sunglen/omni3/doc/JGB37-3530B-24V-333RPM/TB2.rUPbpXXXXXpXpXXXXXXXXXX-665327151.png

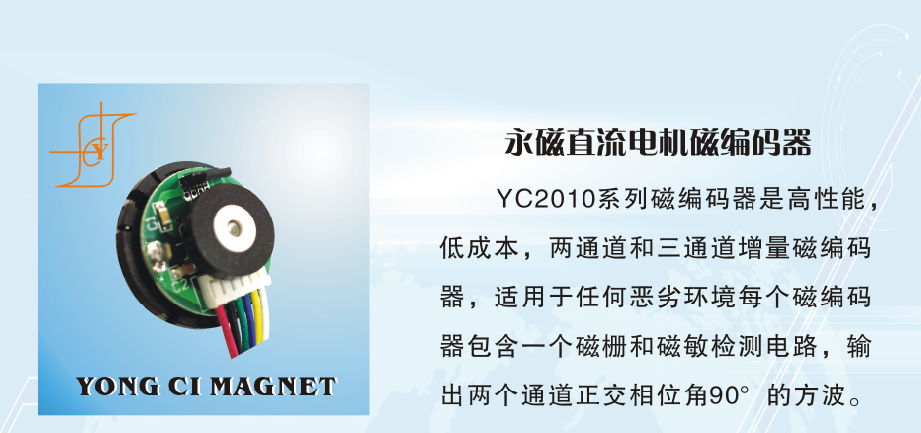
doc/JGB37-3530B-24V-333RPM/TB2.rUPbpXXXXXpXpXXXXXXXXXX-665327151.png
