sunglen/omni3/README.md

omni3
====

AGV with three omni wheels, prototype

- gcc: firmware, gcc

- omni3v0-dist: firmware, Keil uVision

- doc: related documents

- pcb: Eagle Schematics, PCB and Gerber files
