sunglen/omni3/doc/JGB37-3530B-24V-333RPM/TB2dm7LbpXXXXanXpXXXXXXXXXX-665327151 (1).png

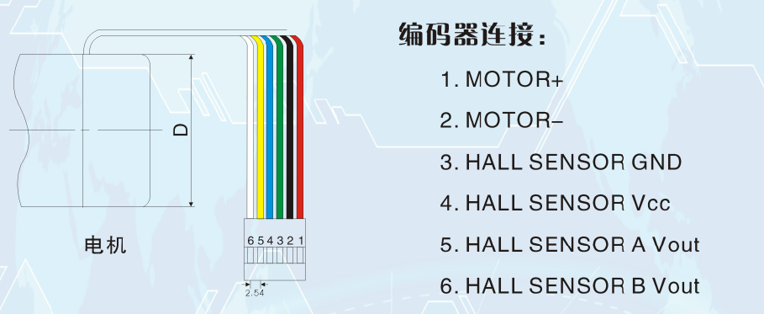
doc/JGB37-3530B-24V-333RPM/TB2dm7LbpXXXXanXpXXXXXXXXXX-665327151 (1).png
