sunglen/omni3/doc/JGB37-3530B-24V-333RPM/TB2ShL6bVXXXXXFXXXXXXXXXXXX-665327151.png

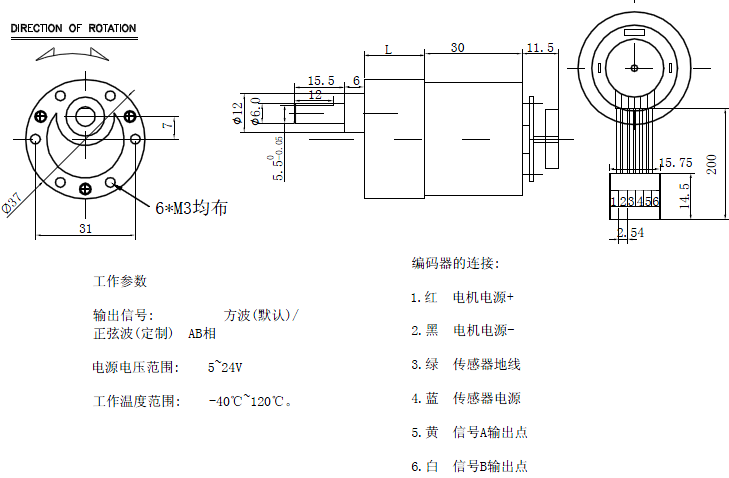
doc/JGB37-3530B-24V-333RPM/TB2ShL6bVXXXXXFXXXXXXXXXXXX-665327151.png
