sunglen/omni3/doc/JGB37-3530B-24V-333RPM/黄A绿B反转.png

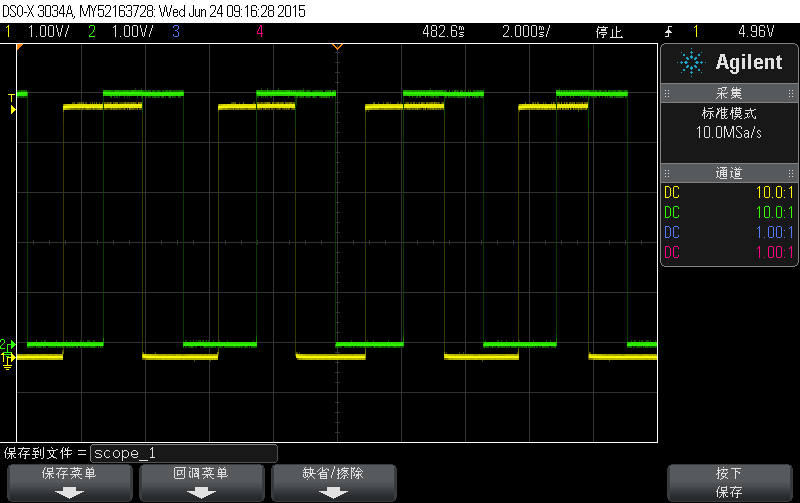
doc/JGB37-3530B-24V-333RPM/黄A绿B反转.png
