sunglen/omni3/pcb/mcs-1-32.brd

## EAGLE design pcb/mcs-1-32.brd (2018-05-24)

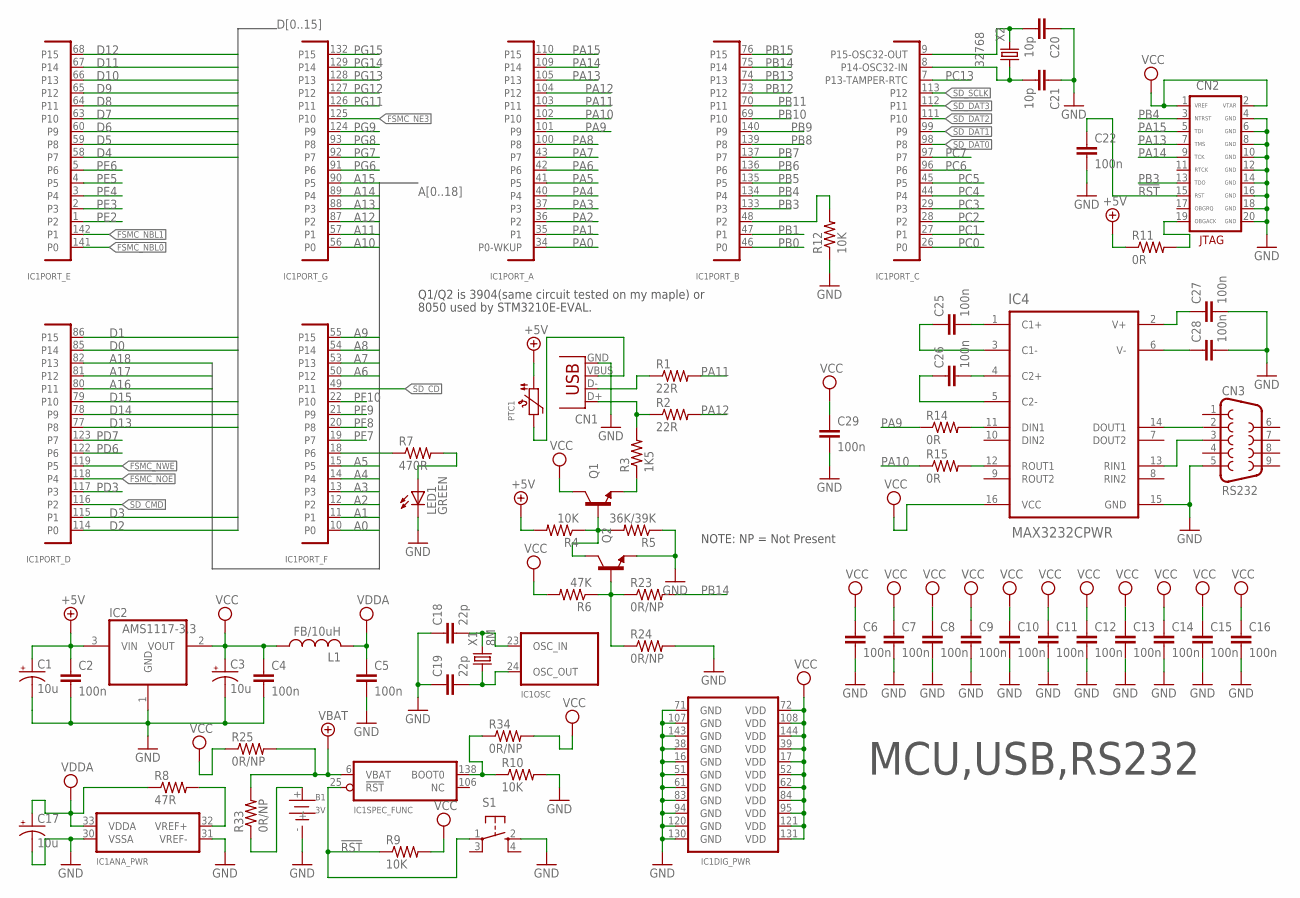
[picture p12: schematic mcs-1-32.sch, sheet 1]

Parts:
B1: 3V; 1220-SMD
C1, C3, C17: 10u; EIA3216
C2, C4, C5, C6, C7, C8, C9, C10, C11, C12, C13, C14, C15, C16, C22, C25, C26, C27, C28, C29: 100n; 0603-CAP
C18, C19: 22p; 0603-CAP
C20, C21: 10p; 0603-CAP
CN1: USBSMD; USB-MINIB
CN2: JTAG-ARM-HDR100; JTAG-ARM
CN3: RS232; DB9
IC1: STM32F103ZE; SQFP-S-20X20-144
IC2: AMS1117-3.3; BURR-BROWN_SOT223
IC4: MAX3232CPWR; SOP65P640X120-16N
L1: FB/10uH; L2012C
LED1: GREEN; CHIPLED_0805
PTC1: PTCPTC0805; PTC0805
Q1, Q2: TRANSISTOR_NPNSOT23-3; SOT23-3
R1, R2: 22R; 0603-RES
R3: 1K5; 0603-RES
R4, R9, R10, R12: 10K; 0603-RES
R5: 36K/39K; 0603-RES
R6: 47K; 0603-RES
R7: 470R; 0603-RES
R8: 47R; 0603-RES
R11, R14, R15: 0R; 0603-RES
R23, R24, R25, R33, R34: 0R/NP; 0603-RES
S1: SWITCH-TACT_SFKHHM
X1: 8M; HC49US
X2: 32768; CRYSTAL-32KHZ-3215

Connections:
!RST: C22.1, CN2.15 (RST), IC1.25 (!RST), R9.1, S1.1
+5V: C1.A (+), C2.1, IC2.3 (VIN), PTC1.1, R4.2, R11.1; also elsewhere on the board
A0: IC1.10 (P0); also elsewhere on the board
A1: IC1.11 (P1); also elsewhere on the board
A2: IC1.12 (P2); also elsewhere on the board
A3: IC1.13 (P3); also elsewhere on the board
A4: IC1.14 (P4); also elsewhere on the board
A5: IC1.15 (P5); also elsewhere on the board
A6: IC1.50 (P12); also elsewhere on the board
A7: IC1.53 (P13); also elsewhere on the board
A8: IC1.54 (P14); also elsewhere on the board
A9: IC1.55 (P15); also elsewhere on the board
A10: IC1.56 (P0); also elsewhere on the board
A11: IC1.57 (P1); also elsewhere on the board
A12: IC1.87 (P2); also elsewhere on the board
A13: IC1.88 (P3); also elsewhere on the board
A14: IC1.89 (P4); also elsewhere on the board
A15: IC1.90 (P5); also elsewhere on the board
A16: IC1.80 (P11); also elsewhere on the board
A17: IC1.81 (P12); also elsewhere on the board
A18: IC1.82 (P13); also elsewhere on the board
D0: IC1.85 (P14); also elsewhere on the board
D1: IC1.86 (P15); also elsewhere on the board
D2: IC1.114 (P0); also elsewhere on the board
D3: IC1.115 (P1); also elsewhere on the board
D4: IC1.58 (P7); also elsewhere on the board
D5: IC1.59 (P8); also elsewhere on the board
D6: IC1.60 (P9); also elsewhere on the board
D7: IC1.63 (P10); also elsewhere on the board
D8: IC1.64 (P11); also elsewhere on the board
D9: IC1.65 (P12); also elsewhere on the board
D10: IC1.66 (P13); also elsewhere on the board
D11: IC1.67 (P14); also elsewhere on the board
D12: IC1.68 (P15); also elsewhere on the board
D13: IC1.77 (P8); also elsewhere on the board
D14: IC1.78 (P9); also elsewhere on the board
D15: IC1.79 (P10); also elsewhere on the board
FSMC_NBL0: IC1.141 (P0); also elsewhere on the board
FSMC_NBL1: IC1.142 (P1); also elsewhere on the board
FSMC_NE3: IC1.125 (P10); also elsewhere on the board
FSMC_NOE: IC1.118 (P4); also elsewhere on the board
FSMC_NWE: IC1.119 (P5); also elsewhere on the board
GND: B1.-, C1.C (-), C2.2, C3.C (-), C4.2, C5.2, C6.2, C7.2, C8.2, C9.2, C10.2, C11.2, C12.2, C13.2, C14.2, C15.2, C16.2, C17.C (-), C18.1, C19.1, C20.1, C21.1, C22.2, C27.2, C28.2, C29.2, CN1.GND, CN2.4 (GND), CN2.6 (GND), CN2.8 (GND), CN2.10 (GND), CN2.12 (GND), CN2.14 (GND), CN2.16 (GND), CN2.18 (GND), CN2.20 (GND), CN3.5, IC1.16 (GND), IC1.30 (VSSA), IC1.31 (VREF-), IC1.38 (GND), IC1.51 (GND), IC1.61 (GND), IC1.71 (GND), IC1.83 (GND), IC1.94 (GND), IC1.107 (GND), IC1.120 (GND), IC1.130 (GND), IC1.143 (GND), IC2.1 (GND), IC4.15 (GND), LED1.C, Q2.2 (E), R5.1, R10.2, R12.1, R24.2, S1.2; also elsewhere on the board
unnamed: Q1.2 (E), R3.1
unnamed: Q1.1 (B), Q2.3 (C), R4.1, R5.2
unnamed: Q2.1 (B), R6.1, R23.1, R24.1
unnamed: CN1.D-, R1.1
unnamed: CN1.D+, R2.1, R3.2
unnamed: IC1.18 (P6), R7.1
unnamed: LED1.A, R7.2
unnamed: IC1.32 (VREF+), R8.2
unnamed: IC1.138 (BOOT0), R10.1, R34.1
unnamed: IC1.48 (P2), R12.2
unnamed: B1.+, R33.1
unnamed: C18.2, IC1.23 (OSC_IN), X1.2
unnamed: C19.2, IC1.24 (OSC_OUT), X1.1
unnamed: C20.2, IC1.9 (P15-OSC32-OUT), X2.2
unnamed: C21.2, IC1.8 (P14-OSC32-IN), X2.1
unnamed: CN2.19 (OBGACK), R11.2
unnamed: IC4.11 (DIN1), R14.2
unnamed: IC4.12 (ROUT1), R15.2
unnamed: CN1.VBUS, PTC1.2
unnamed: CN3.2, IC4.14 (DOUT1)
unnamed: CN3.3, IC4.13 (RIN1)
unnamed: C25.2, IC4.1 (C1+)
unnamed: C25.1, IC4.3 (C1-)
unnamed: C26.2, IC4.4 (C2+)
unnamed: C26.1, IC4.5 (C2-)
unnamed: C27.1, IC4.2 (V+)
unnamed: C28.1, IC4.6 (V-)
PA0: IC1.34 (P0-WKUP); also elsewhere on the board
PA1: IC1.35 (P1); also elsewhere on the board
PA2: IC1.36 (P2); also elsewhere on the board
PA3: IC1.37 (P3); also elsewhere on the board
PA4: IC1.40 (P4); also elsewhere on the board
PA5: IC1.41 (P5); also elsewhere on the board
PA6: IC1.42 (P6); also elsewhere on the board
PA7: IC1.43 (P7); also elsewhere on the board
PA8: IC1.100 (P8); also elsewhere on the board
PA9: IC1.101 (P9), R14.1
PA10: IC1.102 (P10), R15.1
PA11: IC1.103 (P11), R1.2
PA12: IC1.104 (P12), R2.2
PA13: CN2.7 (TMS), IC1.105 (P13)
PA14: CN2.9 (TCK), IC1.109 (P14)
PA15: CN2.5 (TDI), IC1.110 (P15)
PB0: IC1.46 (P0); also elsewhere on the board
PB1: IC1.47 (P1); also elsewhere on the board
PB3: CN2.13 (TDO), IC1.133 (P3)
PB4: CN2.3 (NTRST), IC1.134 (P4)
PB5: IC1.135 (P5); also elsewhere on the board
PB6: IC1.136 (P6); also elsewhere on the board
PB7: IC1.137 (P7); also elsewhere on the board
PB8: IC1.139 (P8); also elsewhere on the board
PB9: IC1.140 (P9); also elsewhere on the board
PB10: IC1.69 (P10); also elsewhere on the board
PB11: IC1.70 (P11); also elsewhere on the board
PB12: IC1.73 (P12); also elsewhere on the board
PB13: IC1.74 (P13); also elsewhere on the board
PB14: IC1.75 (P14), R23.2; also elsewhere on the board
PB15: IC1.76 (P15); also elsewhere on the board
PC0: IC1.26 (P0); also elsewhere on the board
PC1: IC1.27 (P1); also elsewhere on the board
PC2: IC1.28 (P2); also elsewhere on the board
PC3: IC1.29 (P3); also elsewhere on the board
PC4: IC1.44 (P4); also elsewhere on the board
PC5: IC1.45 (P5); also elsewhere on the board
PC6: IC1.96 (P6); also elsewhere on the board
PC7: IC1.97 (P7); also elsewhere on the board
PC13: IC1.7 (P13-TAMPER-RTC); also elsewhere on the board
PD3: IC1.117 (P3); also elsewhere on the board
PD6: IC1.122 (P6); also elsewhere on the board
PD7: IC1.123 (P7); also elsewhere on the board
PE2: IC1.1 (P2); also elsewhere on the board
PE3: IC1.2 (P3); also elsewhere on the board
PE4: IC1.3 (P4); also elsewhere on the board
PE5: IC1.4 (P5); also elsewhere on the board
PE6: IC1.5 (P6); also elsewhere on the board
PF7: IC1.19 (P7); also elsewhere on the board
PF8: IC1.20 (P8); also elsewhere on the board
PF9: IC1.21 (P9); also elsewhere on the board
PF10: IC1.22 (P10); also elsewhere on the board
PG6: IC1.91 (P6); also elsewhere on the board
PG7: IC1.92 (P7); also elsewhere on the board
PG8: IC1.93 (P8); also elsewhere on the board
PG9: IC1.124 (P9); also elsewhere on the board
PG11: IC1.126 (P11); also elsewhere on the board
PG12: IC1.127 (P12); also elsewhere on the board
PG13: IC1.128 (P13); also elsewhere on the board
PG14: IC1.129 (P14); also elsewhere on the board
PG15: IC1.132 (P15); also elsewhere on the board
SD_CD: IC1.49 (P11); also elsewhere on the board
SD_CMD: IC1.116 (P2); also elsewhere on the board
SD_DAT0: IC1.98 (P8); also elsewhere on the board
SD_DAT1: IC1.99 (P9); also elsewhere on the board
SD_DAT2: IC1.111 (P10); also elsewhere on the board
SD_DAT3: IC1.112 (P11); also elsewhere on the board
SD_SCLK: IC1.113 (P12); also elsewhere on the board
VBAT: IC1.6 (VBAT), R25.2, R33.2
VCC: C3.A (+), C4.1, C6.1, C7.1, C8.1, C9.1, C10.1, C11.1, C12.1, C13.1, C14.1, C15.1, C16.1, C29.1, CN2.1 (VREF), CN2.2 (VTAR), IC1.17 (VDD), IC1.39 (VDD), IC1.52 (VDD), IC1.62 (VDD), IC1.72 (VDD), IC1.84 (VDD), IC1.95 (VDD), IC1.108 (VDD), IC1.121 (VDD), IC1.131 (VDD), IC1.144 (VDD), IC2.2 (VOUT), IC4.16 (VCC), L1.1, Q1.3 (C), R6.2, R9.2, R25.1, R34.2; also elsewhere on the board
VDDA: C5.1, C17.A (+), IC1.33 (VDDA), L1.2, R8.1

Notes on the sheet:
Q1/Q2 is 3904(same circuit tested on my maple) or
8050 used by STM3210E-EVAL.
MCU,USB,RS232
NOTE: NP = Not Present

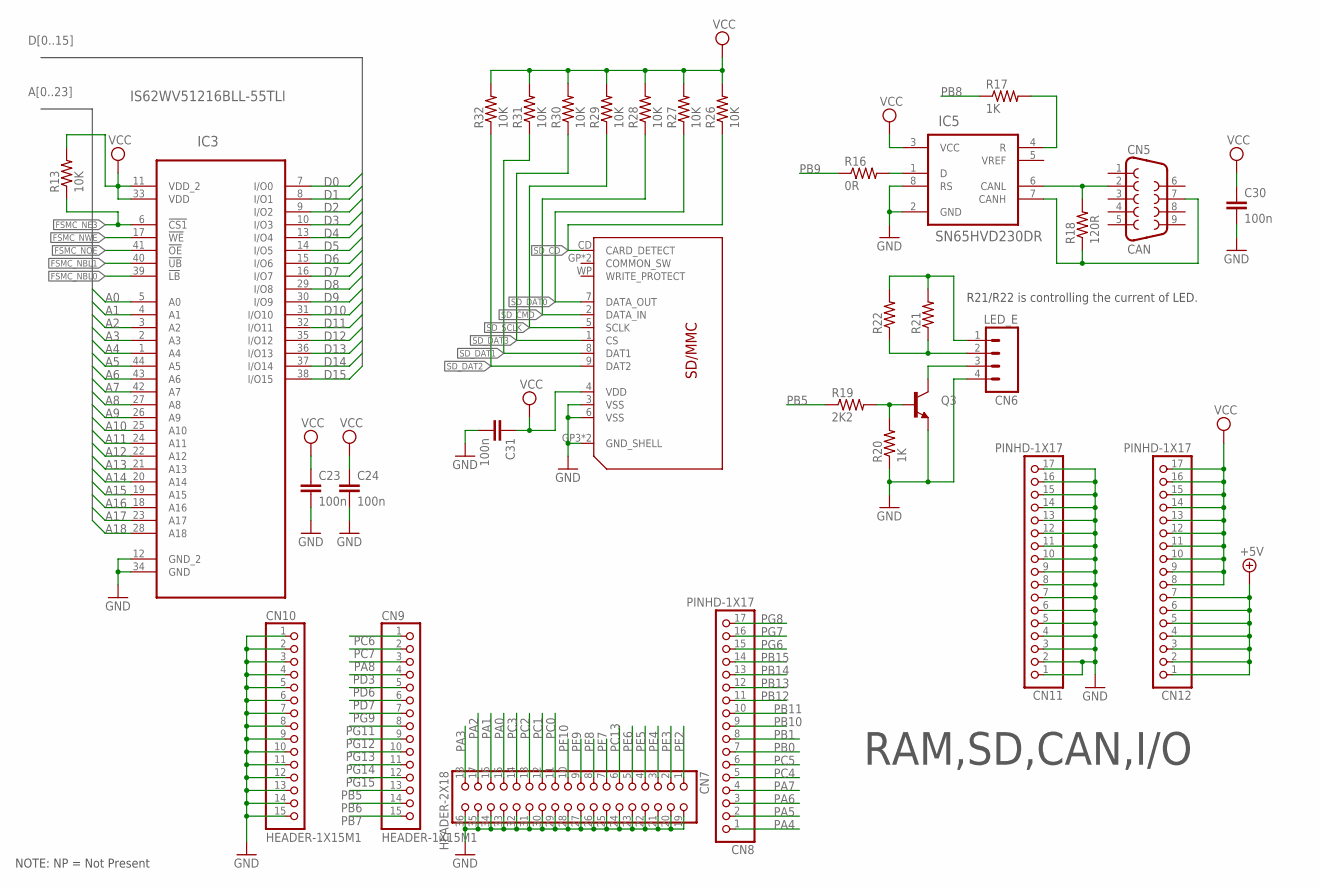
[picture p13: schematic mcs-1-32.sch, sheet 2]

Parts:
C23, C24, C30, C31: 100n; 0603-CAP
CN4: SDMMC06132; 06132
CN5: CAN; DB9_MALE
CN6: LED_E; 1X04_NS
CN7: HEADER-2X18; 2X18U
CN8, CN11, CN12: PINHD-1X17; 1X17M1
CN9, CN10: HEADER-1X15M1; 1X15M1
IC3: IS62WV51216BLL-55TLI; SOP80P1176X120-44N
IC5: SN65HVD230DR; SOIC127P600X175-8N
Q3: TRANSISTOR_NPNSOT23-3; SOT23-3
R13, R26, R27, R28, R29, R30, R31, R32: 10K; 0603-RES
R16: 0R; 0603-RES
R17, R20: 1K; 0603-RES
R18: 120R; 0603-RES
R19: 2K2; 0603-RES
R21, R22: RESISTOR0603-RES; 0603-RES

Connections:
+5V: CN12.1, CN12.2, CN12.3, CN12.4, CN12.5, CN12.6, CN12.7; also elsewhere on the board
A0: IC3.5 (A0); also elsewhere on the board
A1: IC3.4 (A1); also elsewhere on the board
A2: IC3.3 (A2); also elsewhere on the board
A3: IC3.2 (A3); also elsewhere on the board
A4: IC3.1 (A4); also elsewhere on the board
A5: IC3.44 (A5); also elsewhere on the board
A6: IC3.43 (A6); also elsewhere on the board
A7: IC3.42 (A7); also elsewhere on the board
A8: IC3.27 (A8); also elsewhere on the board
A9: IC3.26 (A9); also elsewhere on the board
A10: IC3.25 (A10); also elsewhere on the board
A11: IC3.24 (A11); also elsewhere on the board
A12: IC3.22 (A12); also elsewhere on the board
A13: IC3.21 (A13); also elsewhere on the board
A14: IC3.20 (A14); also elsewhere on the board
A15: IC3.19 (A15); also elsewhere on the board
A16: IC3.18 (A16); also elsewhere on the board
A17: IC3.23 (A17); also elsewhere on the board
A18: IC3.28 (A18); also elsewhere on the board
D0: IC3.7 (I/O0); also elsewhere on the board
D1: IC3.8 (I/O1); also elsewhere on the board
D2: IC3.9 (I/O2); also elsewhere on the board
D3: IC3.10 (I/O3); also elsewhere on the board
D4: IC3.13 (I/O4); also elsewhere on the board
D5: IC3.14 (I/O5); also elsewhere on the board
D6: IC3.15 (I/O6); also elsewhere on the board
D7: IC3.16 (I/O7); also elsewhere on the board
D8: IC3.29 (I/O8); also elsewhere on the board
D9: IC3.30 (I/O9); also elsewhere on the board
D10: IC3.31 (I/O10); also elsewhere on the board
D11: IC3.32 (I/O11); also elsewhere on the board
D12: IC3.35 (I/O12); also elsewhere on the board
D13: IC3.36 (I/O13); also elsewhere on the board
D14: IC3.37 (I/O14); also elsewhere on the board
D15: IC3.38 (I/O15); also elsewhere on the board
FSMC_NBL0: IC3.39 (!LB); also elsewhere on the board
FSMC_NBL1: IC3.40 (!UB); also elsewhere on the board
FSMC_NE3: IC3.6 (!CS1), R13.1; also elsewhere on the board
FSMC_NOE: IC3.41 (!OE); also elsewhere on the board
FSMC_NWE: IC3.17 (!WE); also elsewhere on the board
GND: C23.2, C24.2, C30.2, C31.2, CN4.3 (VSS), CN4.6 (VSS), CN4.GP3 (GND_SHELL), CN4.GP4 (GND_SHELL), CN6.4, CN7.19, CN7.20, CN7.21, CN7.22, CN7.23, CN7.24, CN7.25, CN7.26, CN7.27, CN7.28, CN7.29, CN7.30, CN7.31, CN7.32, CN7.33, CN7.34, CN7.35, CN7.36, CN10.1, CN10.2, CN10.3, CN10.4, CN10.5, CN10.6, CN10.7, CN10.8, CN10.9, CN10.10, CN10.11, CN10.12, CN10.13, CN10.14, CN10.15, CN11.1, CN11.2, CN11.3, CN11.4, CN11.5, CN11.6, CN11.7, CN11.8, CN11.9, CN11.10, CN11.11, CN11.12, CN11.13, CN11.14, CN11.15, CN11.16, CN11.17, IC3.12 (GND_2), IC3.34 (GND), IC5.2 (GND), IC5.8 (RS), Q3.2 (E), R20.1; also elsewhere on the board
unnamed: IC5.1 (D), R16.2
unnamed: IC5.4 (R), R17.2
unnamed: CN5.2, IC5.6 (CANL), R18.2
unnamed: CN5.7, IC5.7 (CANH), R18.1
unnamed: Q3.1 (B), R19.2, R20.2
unnamed: CN6.1, R21.2, R22.2
unnamed: CN6.2, R21.1, R22.1
unnamed: CN6.3, Q3.3 (C)
PA0: CN7.15; also elsewhere on the board
PA1: CN7.16; also elsewhere on the board
PA2: CN7.17; also elsewhere on the board
PA3: CN7.18; also elsewhere on the board
PA4: CN8.1; also elsewhere on the board
PA5: CN8.2; also elsewhere on the board
PA6: CN8.3; also elsewhere on the board
PA7: CN8.4; also elsewhere on the board
PA8: CN9.3; also elsewhere on the board
PB0: CN8.7; also elsewhere on the board
PB1: CN8.8; also elsewhere on the board
PB5: CN9.13, R19.1; also elsewhere on the board
PB6: CN9.14; also elsewhere on the board
PB7: CN9.15; also elsewhere on the board
PB8: R17.1; also elsewhere on the board
PB9: R16.1; also elsewhere on the board
PB10: CN8.9; also elsewhere on the board
PB11: CN8.10; also elsewhere on the board
PB12: CN8.11; also elsewhere on the board
PB13: CN8.12; also elsewhere on the board
PB14: CN8.13; also elsewhere on the board
PB15: CN8.14; also elsewhere on the board
PC0: CN7.11; also elsewhere on the board
PC1: CN7.12; also elsewhere on the board
PC2: CN7.13; also elsewhere on the board
PC3: CN7.14; also elsewhere on the board
PC4: CN8.5; also elsewhere on the board
PC5: CN8.6; also elsewhere on the board
PC6: CN9.1; also elsewhere on the board
PC7: CN9.2; also elsewhere on the board
PC13: CN7.6; also elsewhere on the board
PD3: CN9.4; also elsewhere on the board
PD6: CN9.5; also elsewhere on the board
PD7: CN9.6; also elsewhere on the board
PE2: CN7.1; also elsewhere on the board
PE3: CN7.2; also elsewhere on the board
PE4: CN7.3; also elsewhere on the board
PE5: CN7.4; also elsewhere on the board
PE6: CN7.5; also elsewhere on the board
PF7: CN7.7; also elsewhere on the board
PF8: CN7.8; also elsewhere on the board
PF9: CN7.9; also elsewhere on the board
PF10: CN7.10; also elsewhere on the board
PG6: CN8.15; also elsewhere on the board
PG7: CN8.16; also elsewhere on the board
PG8: CN8.17; also elsewhere on the board
PG9: CN9.7; also elsewhere on the board
PG11: CN9.8; also elsewhere on the board
PG12: CN9.9; also elsewhere on the board
PG13: CN9.10; also elsewhere on the board
PG14: CN9.11; also elsewhere on the board
PG15: CN9.12; also elsewhere on the board
SD_CD: CN4.CD (CARD_DETECT), R26.1; also elsewhere on the board
SD_CMD: CN4.2 (DATA_IN), R28.1; also elsewhere on the board
SD_DAT0: CN4.7 (DATA_OUT), R27.1; also elsewhere on the board
SD_DAT1: CN4.8 (DAT1), R31.1; also elsewhere on the board
SD_DAT2: CN4.9 (DAT2), R32.1; also elsewhere on the board
SD_DAT3: CN4.1 (CS), R30.1; also elsewhere on the board
SD_SCLK: CN4.5 (SCLK), R29.1; also elsewhere on the board
VCC: C23.1, C24.1, C30.1, C31.1, CN4.4 (VDD), CN12.8, CN12.9, CN12.10, CN12.11, CN12.12, CN12.13, CN12.14, CN12.15, CN12.16, CN12.17, IC3.11 (VDD_2), IC3.33 (VDD), IC5.3 (VCC), R13.2, R26.2, R27.2, R28.2, R29.2, R30.2, R31.2, R32.2; also elsewhere on the board

Notes on the sheet:
NOTE: NP = Not Present
RAM,SD,CAN,I/O
R21/R22 is controlling the current of LED.

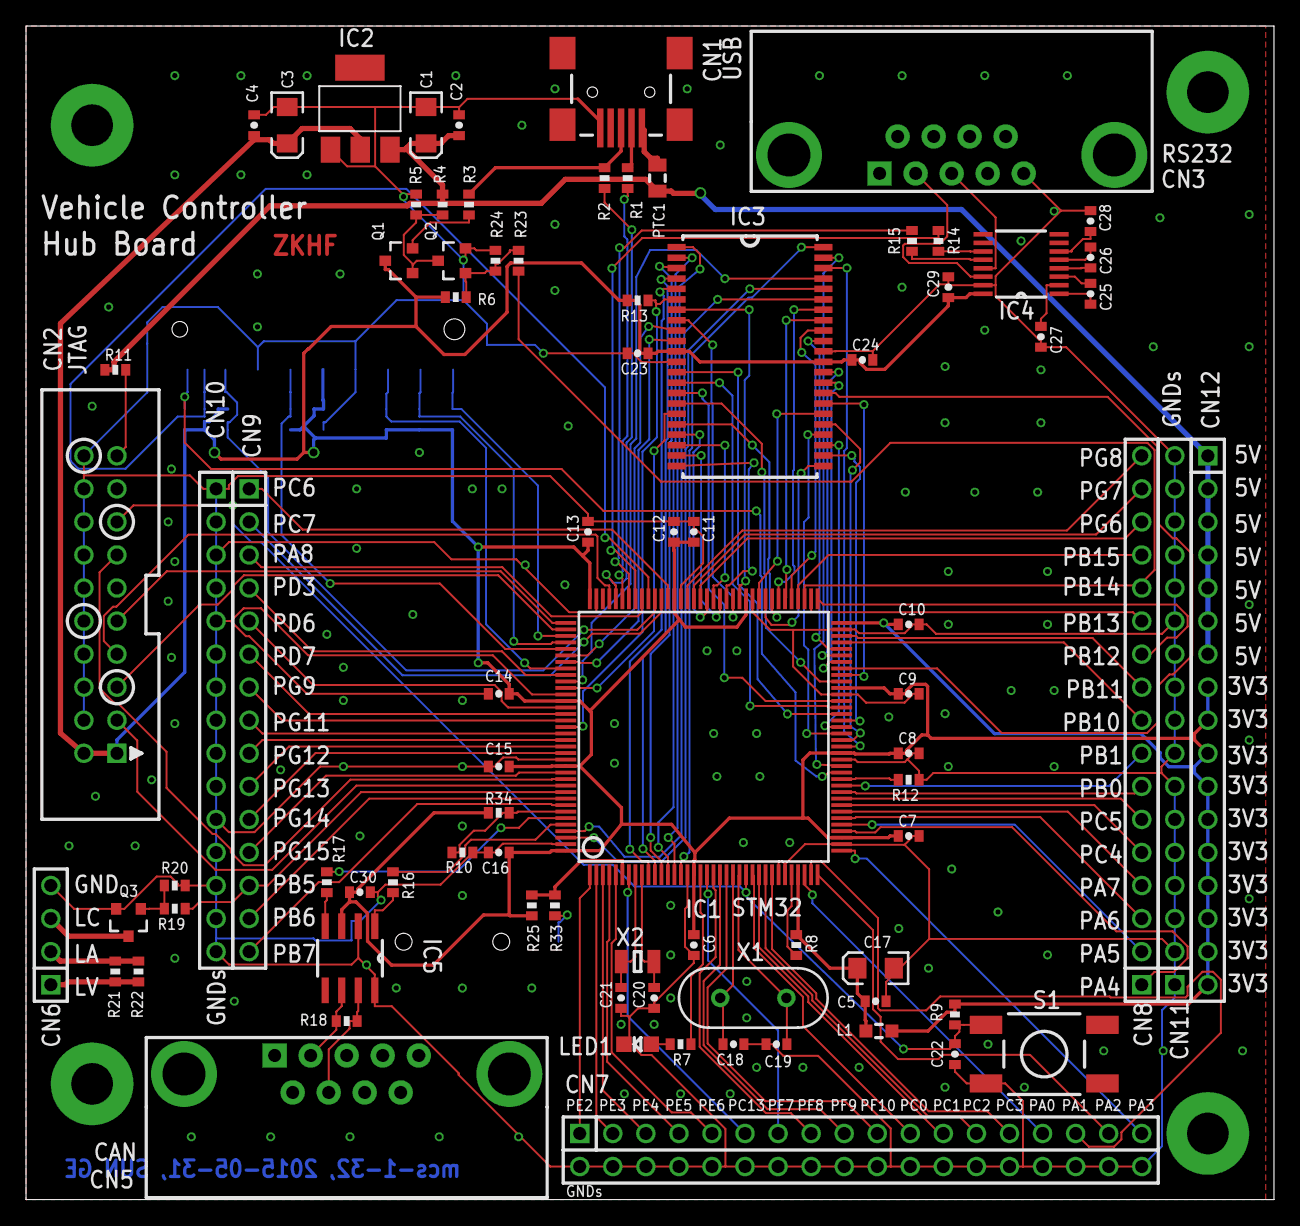
[picture p14: board mcs-1-32.brd from above]

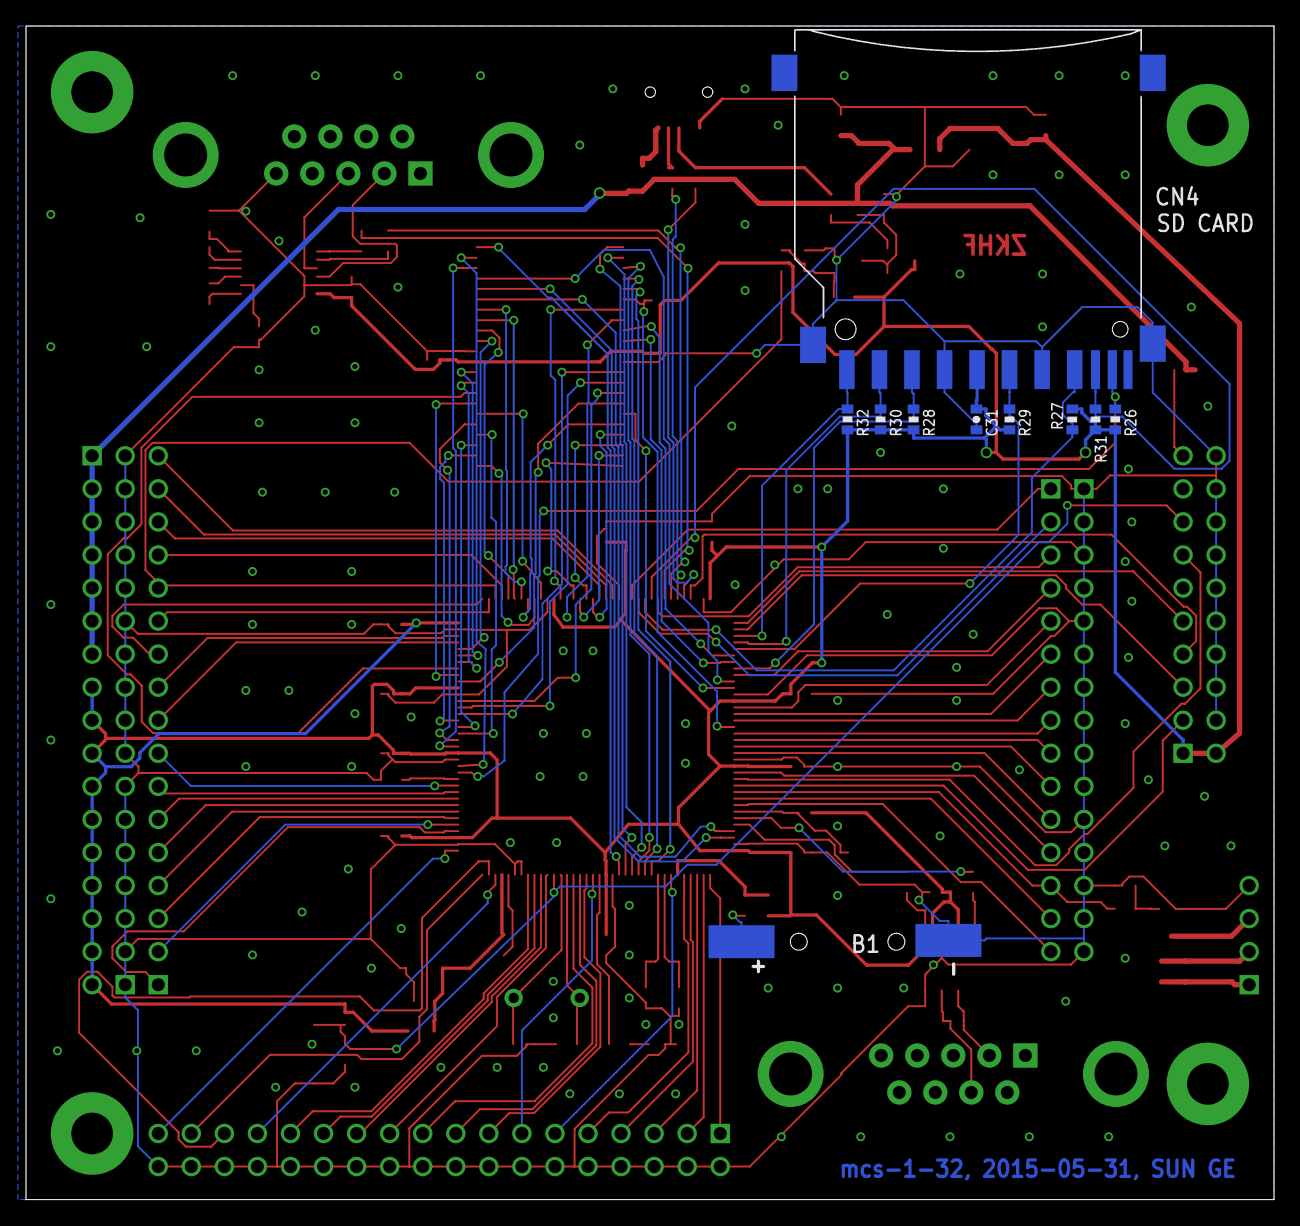
[picture p15: board mcs-1-32.brd from below]

Board: 2 copper layers, 95.9 x 90.2 mm, 92 parts (10 on the bottom side), 149 nets.
