sunglen/omni3/omni3v0-dist/system/usart/usart.c

#include "usart.h"	  
////////////////////////////////////////////////////////////////////////////////// 	 
//如果使用ucos,则包括下面的头文件即可.
#if SYSTEM_SUPPORT_UCOS
#include "includes.h"					//ucos 使用	  
#endif
//////////////////////////////////////////////////////////////////////////////////	 
//本程序只供学习使用，未经作者许可，不得用于其它任何用途
//ALIENTEK STM32开发板
//串口1初始化		   
//正点原子@ALIENTEK
//技术论坛:www.openedv.com
//修改日期:2012/8/18
//版本：V1.5
//版权所有，盗版必究。
//Copyright(C) 广州市星翼电子科技有限公司 2009-2019
//All rights reserved
//********************************************************************************
//V1.3修改说明 
//支持适应不同频率下的串口波特率设置.
//加入了对printf的支持
//增加了串口接收命令功能.
//修正了printf第一个字符丢失的bug
//V1.4修改说明
//1,修改串口初始化IO的bug
//2,修改了USART_RX_STA,使得串口最大接收字节数为2的14次方
//3,增加了USART_REC_LEN,用于定义串口最大允许接收的字节数(不大于2的14次方)
//4,修改了EN_USART1_RX的使能方式
//V1.5修改说明
//1,增加了对UCOSII的支持
////////////////////////////////////////////////////////////////////////////////// 	  
 

//////////////////////////////////////////////////////////////////
//加入以下代码,支持printf函数,而不需要选择use MicroLIB	  
//#if 1
//#pragma import(__use_no_semihosting)             
////标准库需要的支持函数                 
//struct __FILE 
//{ 
//	int handle; 
//	/* Whatever you require here. If the only file you are using is */ 
//	/* standard output using printf() for debugging, no file handling */ 
//	/* is required. */ 
//}; 
///* FILE is typedef’ d in stdio.h. */ 
//FILE __stdout;       
////定义_sys_exit()以避免使用半主机模式    
//_sys_exit(int x) 
//{ 
//	x = x; 
//} 
////重定义fputc函数 
//int fputc(int ch, FILE *f)
//{      
//	while((USART1->SR&0X40)==0);//循环发送,直到发送完毕   
//	USART1->DR = (u8) ch;      
//	return ch;
//}
//#endif 
//end
//////////////////////////////////////////////////////////////////

//use xprintf from elm_chan, not stdio.
void usart1_tx_byte(u8 ch)
{
	while((USART1->SR&0x40)==0);//循环发送,直到发送完毕   
  USART1->DR = (u8) ch;
}

void usart2_tx_byte(u8 ch)
{
	while((USART2->SR&0x40)==0);//循环发送,直到发送完毕   
  USART2->DR = (u8) ch;
}


#if EN_USART1_RX   //如果使能了接收
////串口1中断服务程序
////注意,读取USARTx->SR能避免莫名其妙的错误   	
//u8 USART_RX_BUF[USART_REC_LEN];     //接收缓冲,最大USART_REC_LEN个字节.
////接收状态
////bit15，	接收完成标志
////bit14，	接收到0x0d
////bit13~0，	接收到的有效字节数目
//u16 USART_RX_STA=0;       //接收状态标记	  
//  
//void USART1_IRQHandler(void)
//{
//	u8 res;	
//#ifdef OS_CRITICAL_METHOD 	//如果OS_CRITICAL_METHOD定义了,说明使用ucosII了.
//	OSIntEnter();    
//#endif
//	if(USART1->SR&(1<<5))//接收到数据
//	{	 
//		res=USART1->DR; 
//		if((USART_RX_STA&0x8000)==0)//接收未完成
//		{
//			if(USART_RX_STA&0x4000)//接收到了0x0d
//			{
//				if(res!=0x0a)USART_RX_STA=0;//接收错误,重新开始
//				else USART_RX_STA|=0x8000;	//接收完成了 
//			}else //还没收到0X0D
//			{	
//				if(res==0x0d)USART_RX_STA|=0x4000;
//				else
//				{
//					USART_RX_BUF[USART_RX_STA&0X3FFF]=res;
//					USART_RX_STA++;
//					if(USART_RX_STA>(USART_REC_LEN-1))USART_RX_STA=0;//接收数据错误,重新开始接收	  
//				}		 
//			}
//		}  		 									     
//	}
//#ifdef OS_CRITICAL_METHOD 	//如果OS_CRITICAL_METHOD定义了,说明使用ucosII了.
//	OSIntExit();  											 
//#endif
//} 

//u8 usart1_rx_byte(void)
//{
//	u8 usart1_rx_buf;
//	
//  while((USART1->SR&(1<<5))==0) //test RXNE bit
//		// add sleep code here
//    ;
//	usart1_rx_buf=USART1->DR;
//  
//  return usart1_rx_buf;
//}

u8 usart1_rx_buf;
u8 usart1_rx_flag=0;

u8 usart1_rx_byte(void)
{
  while(usart1_rx_flag == 0)
		// add sleep code here
    ;
  usart1_rx_flag = 0;
  
  return usart1_rx_buf;
}

void USART1_IRQHandler(void)
{	
	if(USART1->SR&(1<<5))//test RXNE bit to judge data received or not.
	{	
		//read USART_DR will clear RXNE bit.
		//or, RXNE should be cleared manually.
		//otherwise, ISR will run again and again.
		usart1_rx_buf=USART1->DR;
		usart1_rx_flag=1; 				     
	}
} 

#endif							

#if EN_USART2_RX   //如果使能了接收
//串口2中断服务程序
//注意,读取USARTx->SR能避免莫名其妙的错误

u8 usart2_rx_buf;
u8 usart2_rx_flag=0;

u8 usart2_rx_byte(void)
{
  while(usart2_rx_flag == 0)
		// add sleep code here
    ;
  usart2_rx_flag = 0;
  
  return usart2_rx_buf;
}

void USART2_IRQHandler(void)
{	
	if(USART2->SR&(1<<5))//test RXNE bit to judge data received or not.
	{	
		//read USART_DR will clear RXNE bit.
		//or, RXNE should be cleared manually.
		//otherwise, ISR will run again and again.
		usart2_rx_buf=USART2->DR;
		usart2_rx_flag=1; 				     
	}
} 
#endif


//初始化IO 串口1 defalut is PA9/PA10
//pclk2:PCLK2时钟频率(Mhz)
//bound:波特率
//CHECK OK
//091209
void uart1_init(u32 pclk2,u32 bound)
{  	 
	float temp;
	u16 mantissa;
	u16 fraction;	   
	temp=(float)(pclk2*1000000)/(bound*16);//得到USARTDIV
	mantissa=temp;				 //得到整数部分
	fraction=(temp-mantissa)*16; //得到小数部分	 
  mantissa<<=4;
	mantissa+=fraction; 
	RCC->APB2ENR|=1<<2;   //使能PORTA口时钟  
	RCC->APB2ENR|=1<<14;  //使能串口时钟 
	GPIOA->CRH&=0xFFFFF00F;//IO状态设置
	GPIOA->CRH|=0x000008B0;//IO状态设置
		  
	RCC->APB2RSTR|=1<<14;   //复位串口1
	RCC->APB2RSTR&=~(1<<14);//停止复位	   	   
	//波特率设置
 	USART1->BRR=mantissa; // 波特率设置	 
	USART1->CR1|=0X200C;  //1位停止,无校验位.
#if EN_USART1_RX		  //如果使能了接收
	//使能接收中断
	USART1->CR1|=1<<8;    //PE中断使能
	USART1->CR1|=1<<5;    //接收缓冲区非空中断使能	    	
	MY_NVIC_Init(3,3,USART1_IRQn,2);//组2，最低优先级 
	xdev_in(usart1_rx_byte);
#endif
	//setup for xprintf
  xdev_out(usart1_tx_byte);
}

//default is PA2=TXD; PA3=RXD
//maxium value of pclk1 is 36MHz
void uart2_init(u32 pclk1,u32 bound)
{  	 
	float temp;
	u16 mantissa;
	u16 fraction;	   
	temp=(float)(pclk1*1000000)/(bound*16);//得到USARTDIV
	mantissa=temp;				 //得到整数部分
	fraction=(temp-mantissa)*16; //得到小数部分	 
  mantissa<<=4;
	mantissa+=fraction; 
	RCC->APB2ENR|=1<<2;   //使能PORTA口时钟  
	RCC->APB1ENR|=1<<17;  //使能串口时钟 
	GPIOA->CRL&=0xFFFF00FF;//IO状态设置
	GPIOA->CRL|=0X00008B00;//IO状态设置
		  
	RCC->APB1RSTR|=1<<17;   //复位串口1
	RCC->APB1RSTR&=~(1<<17);//停止复位	   	   
	//波特率设置
 	USART2->BRR=mantissa; // 波特率设置	 
	USART2->CR1|=0x200C;  //1位停止,无校验位.
#if EN_USART2_RX		  //如果使能了接收
	//使能接收中断
	USART2->CR1|=1<<8;    //PE中断使能
	USART2->CR1|=1<<5;    //接收缓冲区非空中断使能	    	
	MY_NVIC_Init(3,3,USART2_IRQn,2);//组2，最低优先级 
	xdev_in(usart2_rx_byte);
#endif
  xdev_out(usart2_tx_byte);
}
