sunglen/omni3/(commit log)

2017-11-22 add doc and pcb
    [mcs-1-32.brd, mcs-1-32.sch]
2018-05-24 add openocd config file
    [mcs-1-32.cfg]
