sunglen/omni3/(notices)

Notices in the files:
omni3v0-dist/system/sys/sys.c:
Copyright(C) ¹ãÖÝÊÐÐÇÒíµç×Ó¿Æ¼¼ÓÐÏÞ¹«Ë¾ 2009-2019
All rights reserved
